RodrigoQ99/PCIe-Switch-4xNVMe/esquematico/BOM_PCIe_Switch_4xNVMe.csv

Item | Cantidad | Valor | Parte | Footprint | Referencias
1 | 6 | HI1812V101R-10 | BEAD | L1812 | BD1 BD3 BD4 BD6 BD7 BD8
2 | 11 | 22uF25V | C_MLCC | C1206 | C1 C2 C8 C10 C12 C13 C16 C28 C31 C36 C41
3 | 2 | 100uF/16V | CAP_0 | 7_3X4_3X2_8 | C3 C29
4 | 28 | 0.1uF | C_MLCC | C0402 | C4 C5 C9 C11 C14 C15 C17 C30 C32 C37 C39 C40 C42 C43 C44 C53 C54 C102 C103 C104 C107 C108 C110 C111 C114 C115 C116 C117
5 | 6 | 47uF6.3V | C_MLCC | C0805 | C6 C33 C144 C145 C150 C155
6 | 2 | 330uF/6.3V | CAP_0 | 7_3X4_3X2_8 | C7 C34
7 | 2 | X_SS | C_MLCC | C0402 | C18 C35
8 | 3 | 47uF25V | C_MLCC | C1206 | C19 C20 C21
9 | 5 | 100uF6.3V | C_MLCC | C1206 | C22 C23 C24 C25 C26
10 | 1 | 470uF/6.3V | CAP_0 | 7_3X4_3X2_8 | C27
11 | 7 | 10uF10V | C_MLCC | C0603 | C38 C45 C52 C100 C109 C113 C118
12 | 8 | 0.22uF | C_MLCC_0 | C0402 | C46 C47 C48 C49 C50 C51 C55 C56
13 | 14 | 10uF/6.3V | C_MLCC_0 | C0402 | C99 C101 C106 C119 C123 C127 C131 C135 C140 C146 C151 C156 C160 C164
14 | 1 | 0.1uF | C_MLCC_0 | C0402 | C112
15 | 11 | 4.7uF/6.3V | C_MLCC_0 | C0402 | C120 C124 C128 C132 C136 C141 C147 C152 C157 C161 C165
16 | 20 | 0.1uF | C_MLCC | C0402 | C121 C122 C125 C126 C129 C130 C133 C134 C137 C142 C143 C148 C149 C153 C154 C158 C159 C162 C166 C167
17 | 2 | X_100uF6.3V | C_MLCC | C1206 | C138 C139
18 | 1 | 47uF6.3V | C_MLCC | C0805 | C163
19 | 2 | 0.1uF | C_MLCC | C0402 | C244 C245
20 | 8 | 220nF | CAP NP | c0402 | C741 C742 C751 C752 C761 C762 C771 C772
21 | 8 | 22uF | CAP NP | c0805 | C743 C744 C753 C754 C763 C764 C773 C774
22 | 8 | 0.1uF | CAP NP | c0402 | C745 C746 C755 C756 C765 C766 C775 C776
23 | 5 | Red | LED_0 | LED-0805 | DS1 DS2 DS3 DS4 DS5
24 | 4 | M.2_M-KEY_2280 | HEADER 38x2 | M2_MKEY_2280 | J44 J45 J46 J47
25 | 1 | X_PCIex4 | PCIex4 | PCI_EXPRESS_X4 | P2
26 | 1 | PWRCONN6P | PWR_ATX12V_3 | 455580003 | PWR1
27 | 2 | 2N7002A | NMOS_SGD_0 | SOT23SGD_T | Q1 Q2
28 | 14 | 0R | R_2P | R0402 | R1 R3 R6 R10 R20 R22 R48 R139 R153 R154 R155 R156 RB2 RB4
29 | 5 | X_0R | R_2P | R0402 | R2 R7 R8 R21 R135
30 | 2 | 2.45K 1% | R_2P | R0402 | R4 R23
31 | 2 | 1M 1% | R_2P | R0402 | R5 R24
32 | 1 | X_66k | R_2P | R0402 | R9
33 | 1 | 1K | R_2P | R0402 | R11
34 | 15 | 330R | R_2P | R0402 | R12 R13 R17 R19 R72 R79 RD1 RD2 RD5 RD14 RD15 RD17 RD18 RD19 RD85
35 | 1 | 326R1% | R_2P | R0402 | R14
36 | 20 | 5.1K | R_2P | R0402 | R16 R18 R51 R52 R54 R55 R143 R144 R148 R152 RP7 RP8 RP9 RP10 RP11 RP12 RP75 RP76 RP176 RP177
37 | 1 | 3.9K1% | R_2P | R0402 | R25
38 | 2 | 20K1% | R_2P | R0402 | R26 R28
39 | 1 | 25K1% | R_2P | R0402 | R27
40 | 2 | X_0R | R_2 | R0402 | R29 R30
41 | 1 | X_330R | R_2P | R0402 | R59
42 | 1 | 200K | R_2P | R0402 | R74
43 | 10 | 0R | R | R0402 | R88 R89 R90 R91 R92 R93 R157 R158 R159 R160
44 | 1 | 200R1% | R_4 | R0402 | R102
45 | 6 | X_330R | R | R0402 | RD7 RD8 RD9 RD10 RD11 RD12
46 | 3 | 330R | R | R0402 | RD13 RD81 RD82
47 | 2 | X_1.82K | R_2P | R0402 | RP21 RP23
48 | 2 | 1.16K | R_2P | R0402 | RP24 RP25
49 | 2 | 5.1K | R | R0402 | RP87 RP200
50 | 14 | X_TESTPOINT | TP_0 | TESTPIN25 | TP1 TP2 TP3 TP4 TP5 TP6 TP7 TP8 TP9 TP10 TP11 TP12 TP13 TP14
51 | 2 | LMZ31704/07/10 | LMZ31704/70/10 | B3QFN-42 | U1 U3
52 | 1 | LMZ31530/20 | LM31530/20 | QFN72-16R15X15R15-_8 | U2
53 | 2 | AP7361C-FGE-7 | AP7361C_0 | DFN8-0303-_65 | U4 U5
54 | 1 | PI7C9X3G808GP | PI7C9X3G808GP_17 | HFCBGA_196_15X15 | U6
55 | 1 | PI4ULS5V108LEX | PI4ULS5V108LEX | tssop20-6_5-_65 | U10
56 | 1 | 74HC08S14-13 | 74HC08_6 | SO14-6-1_27 | U23
57 | 1 | PT7M7811STBE | TCM811_1 | SOT143 | U27
