RodrigoQ99/PCIe-Switch-4xNVMe/(list of files, cad)

Other CAD files:
layout/footprints/455580003.psm
layout/footprints/7_3x4_3x2_8.psm
layout/footprints/b3qfn-42.psm
layout/footprints/c0402.psm
layout/footprints/c0402_bga.psm
layout/footprints/c0603.psm
layout/footprints/c0805.psm
layout/footprints/c1206.psm
layout/footprints/dfn8-0303-_65.psm
layout/footprints/hfcbga_196_15x15.psm
layout/footprints/l1812.psm
layout/footprints/led-0805.psm
layout/footprints/m2_mkey_2280.psm
layout/footprints/pci_express_x4.psm
layout/footprints/qfn72-16r15x15r15-_8.psm
layout/footprints/r0402.psm
layout/footprints/so14-6-1_27.psm
layout/footprints/sot23sgd_t.psm
layout/footprints/testpin25.psm
layout/footprints/tssop20-6_5-_65.psm
