RodrigoQ99/PCIe-Switch-4xNVMe/esquematico/PCIe_Switch_4xNVMe_esquematico.pdf

5

4

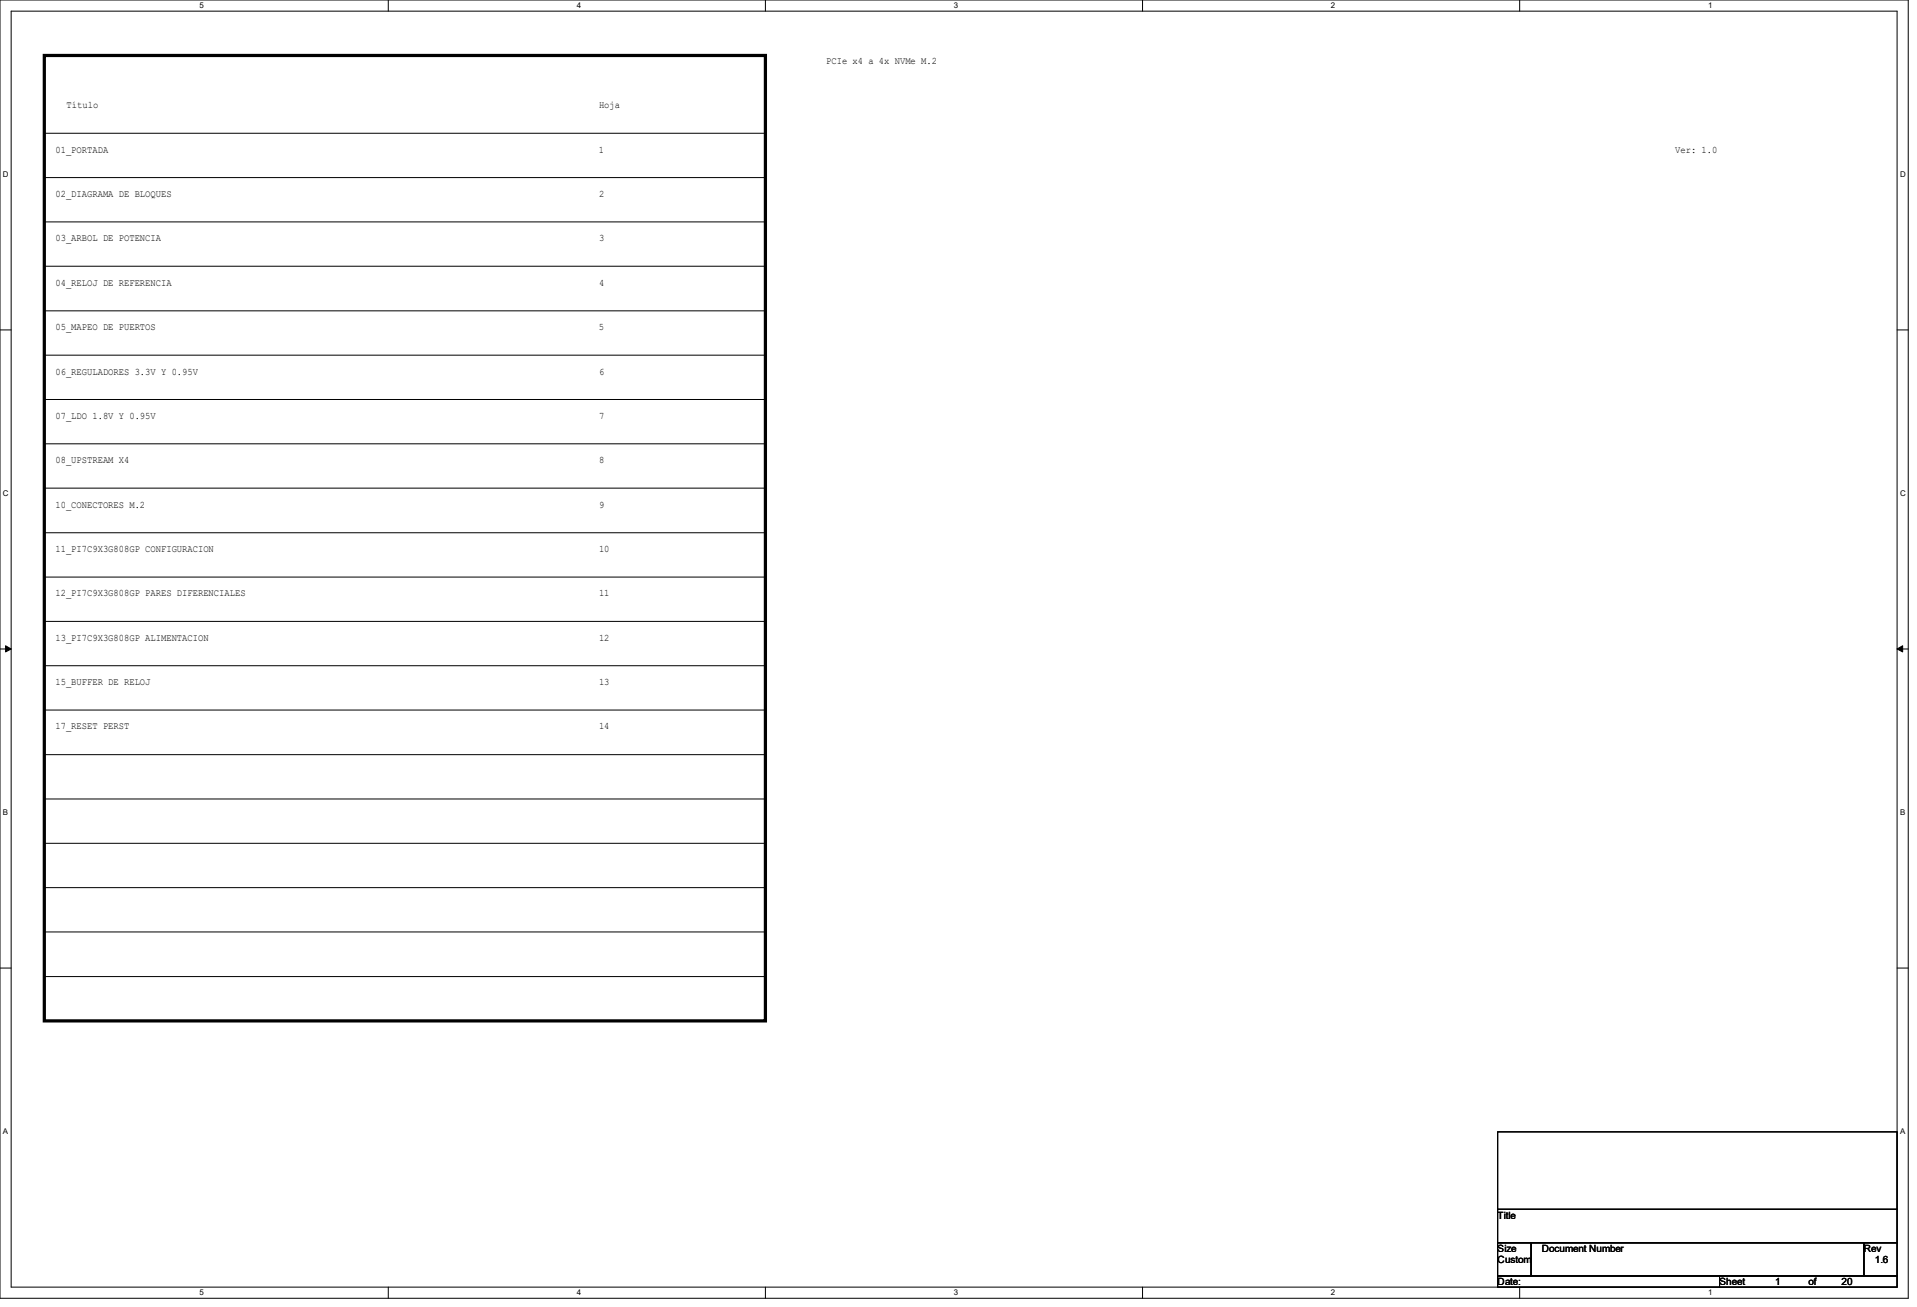
[picture p6: page 1]
01_PORTADA; Título; Hoja; 10_CONECTORES M.2; 03_ARBOL DE POTENCIA; 05_MAPEO DE PUERTOS; PCIe x4 a 4x NVMe M.2; 12_PI7C9X3G808GP PARES DIFERENCIALES; 15_BUFFER DE RELOJ; 11_PI7C9X3G808GP CONFIGURACION; Ver: 1.0; 08_UPSTREAM X4; 13_PI7C9X3G808GP ALIMENTACION; 04_RELOJ DE REFERENCIA; 02_DIAGRAMA DE BLOQUES; 17_RESET PERST; 06_REGULADORES 3.3V Y 0.95V; 07_LDO 1.8V Y 0.95V; Title Size; Document Number; Rev Date:; Sheet; of Custom; 20 Title Size

## DIAGRAMA DE BLOQUES - PCIe Gen3 x4 a 4 SSD NVMe M.2

## P2 - Gold fingers x4

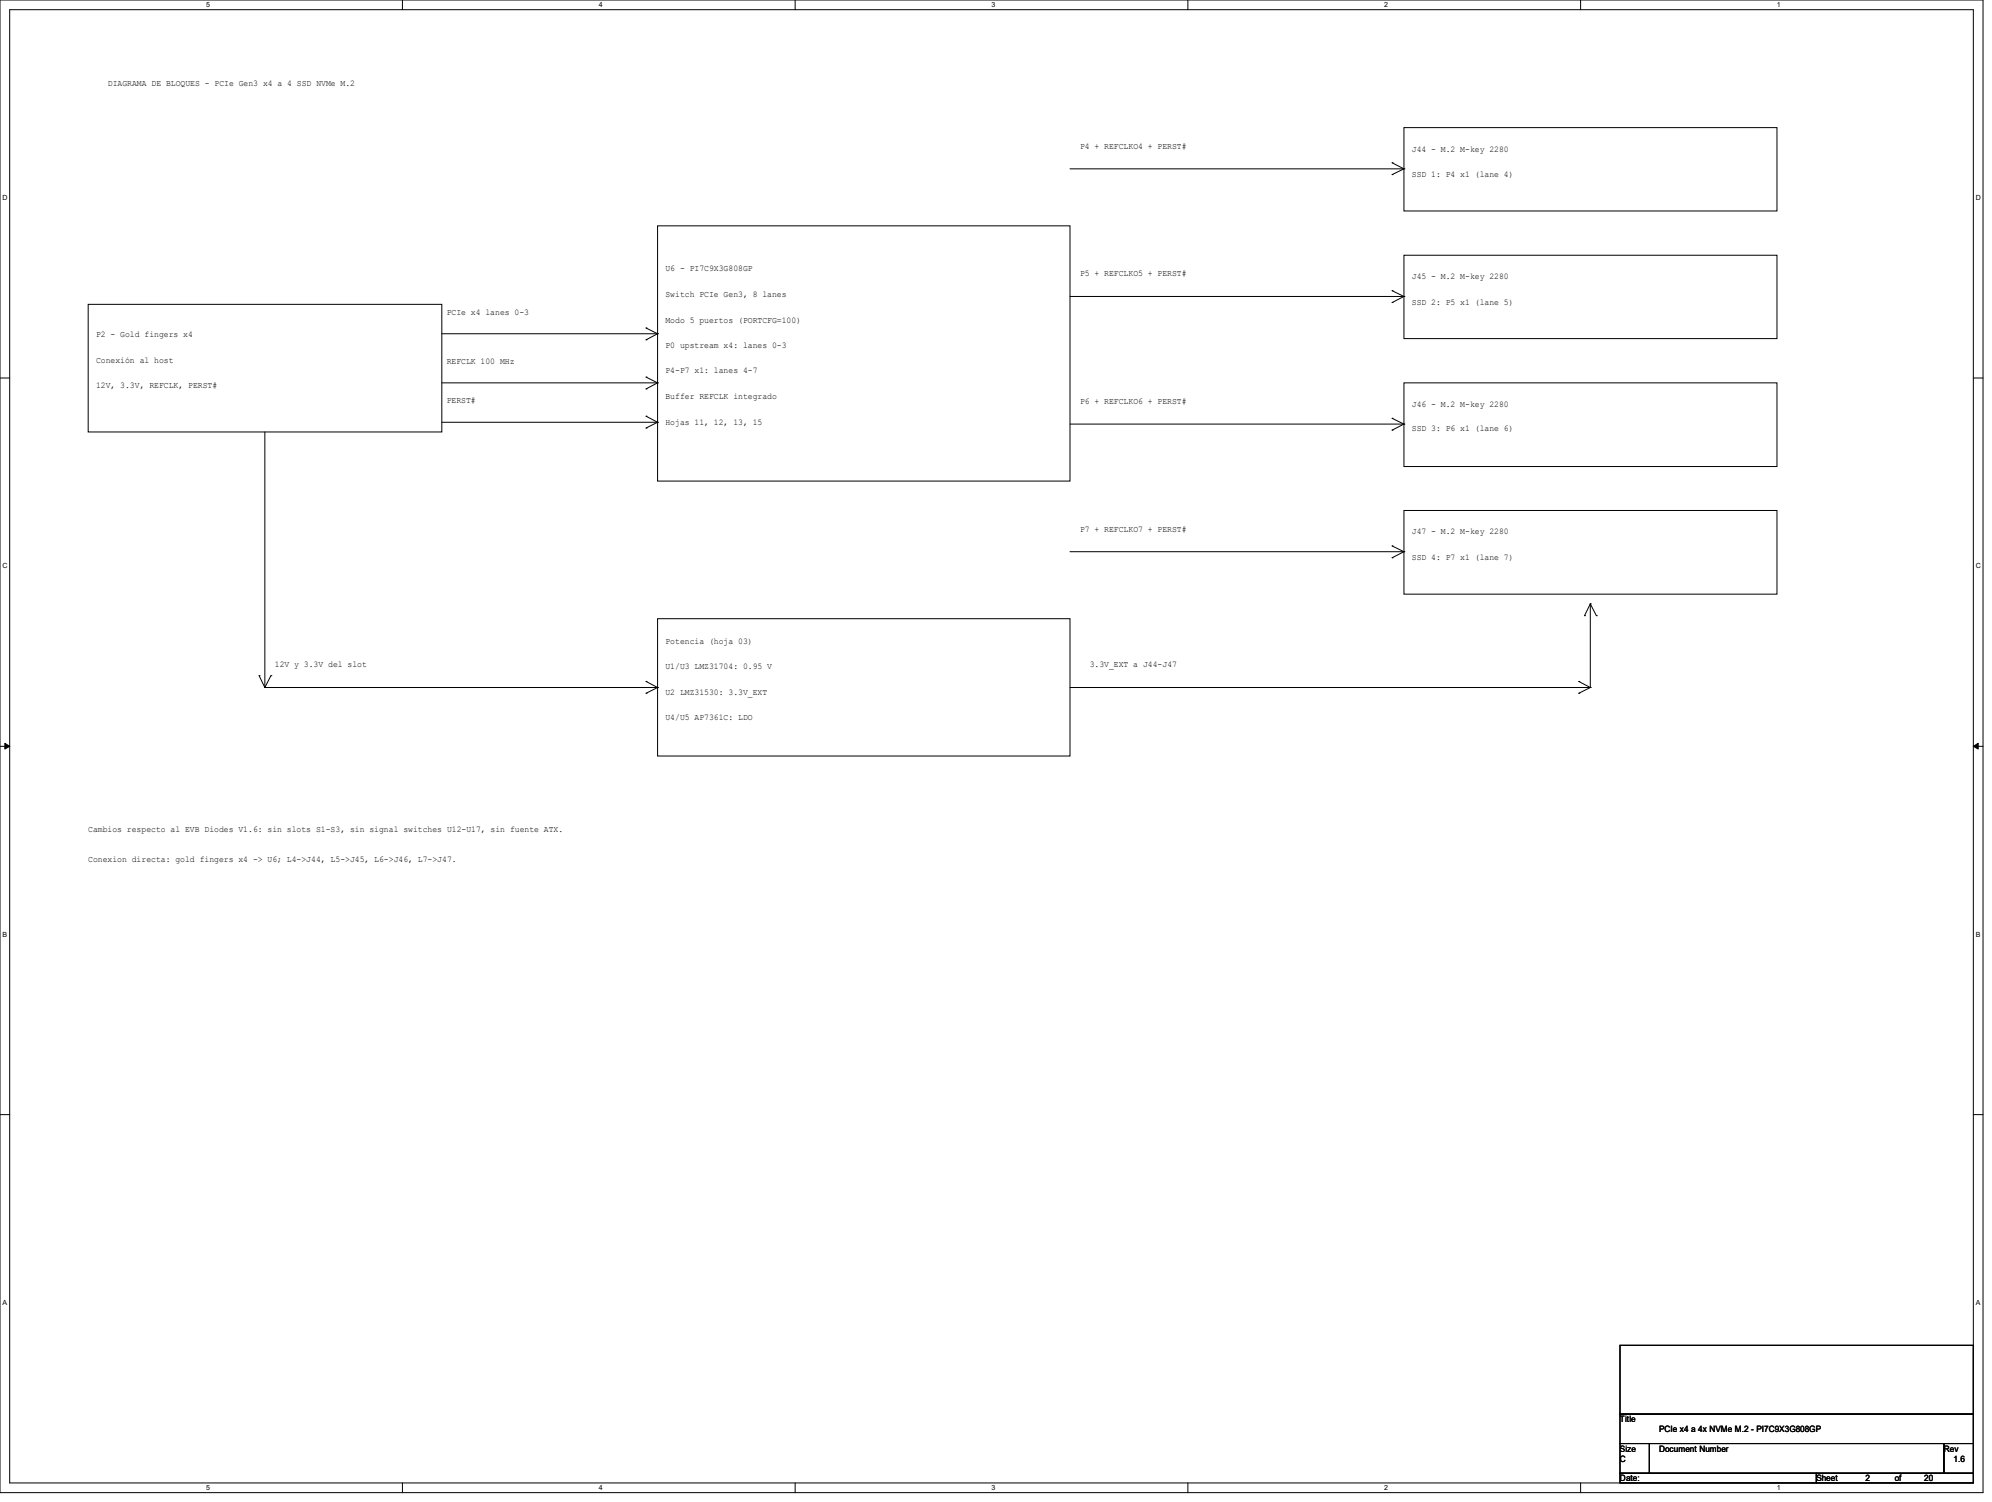
[picture p7: page 2]

Cambios respecto al EVB Diodes V1.6: sin slots S1-S3, sin signal switches U12-U17, sin fuente ATX.

Conexion directa: gold fingers x4 -> U6; L4->J44, L5->J45, L6->J46, L7->J47.

D D

# ÁRBOL DE POTENCIA

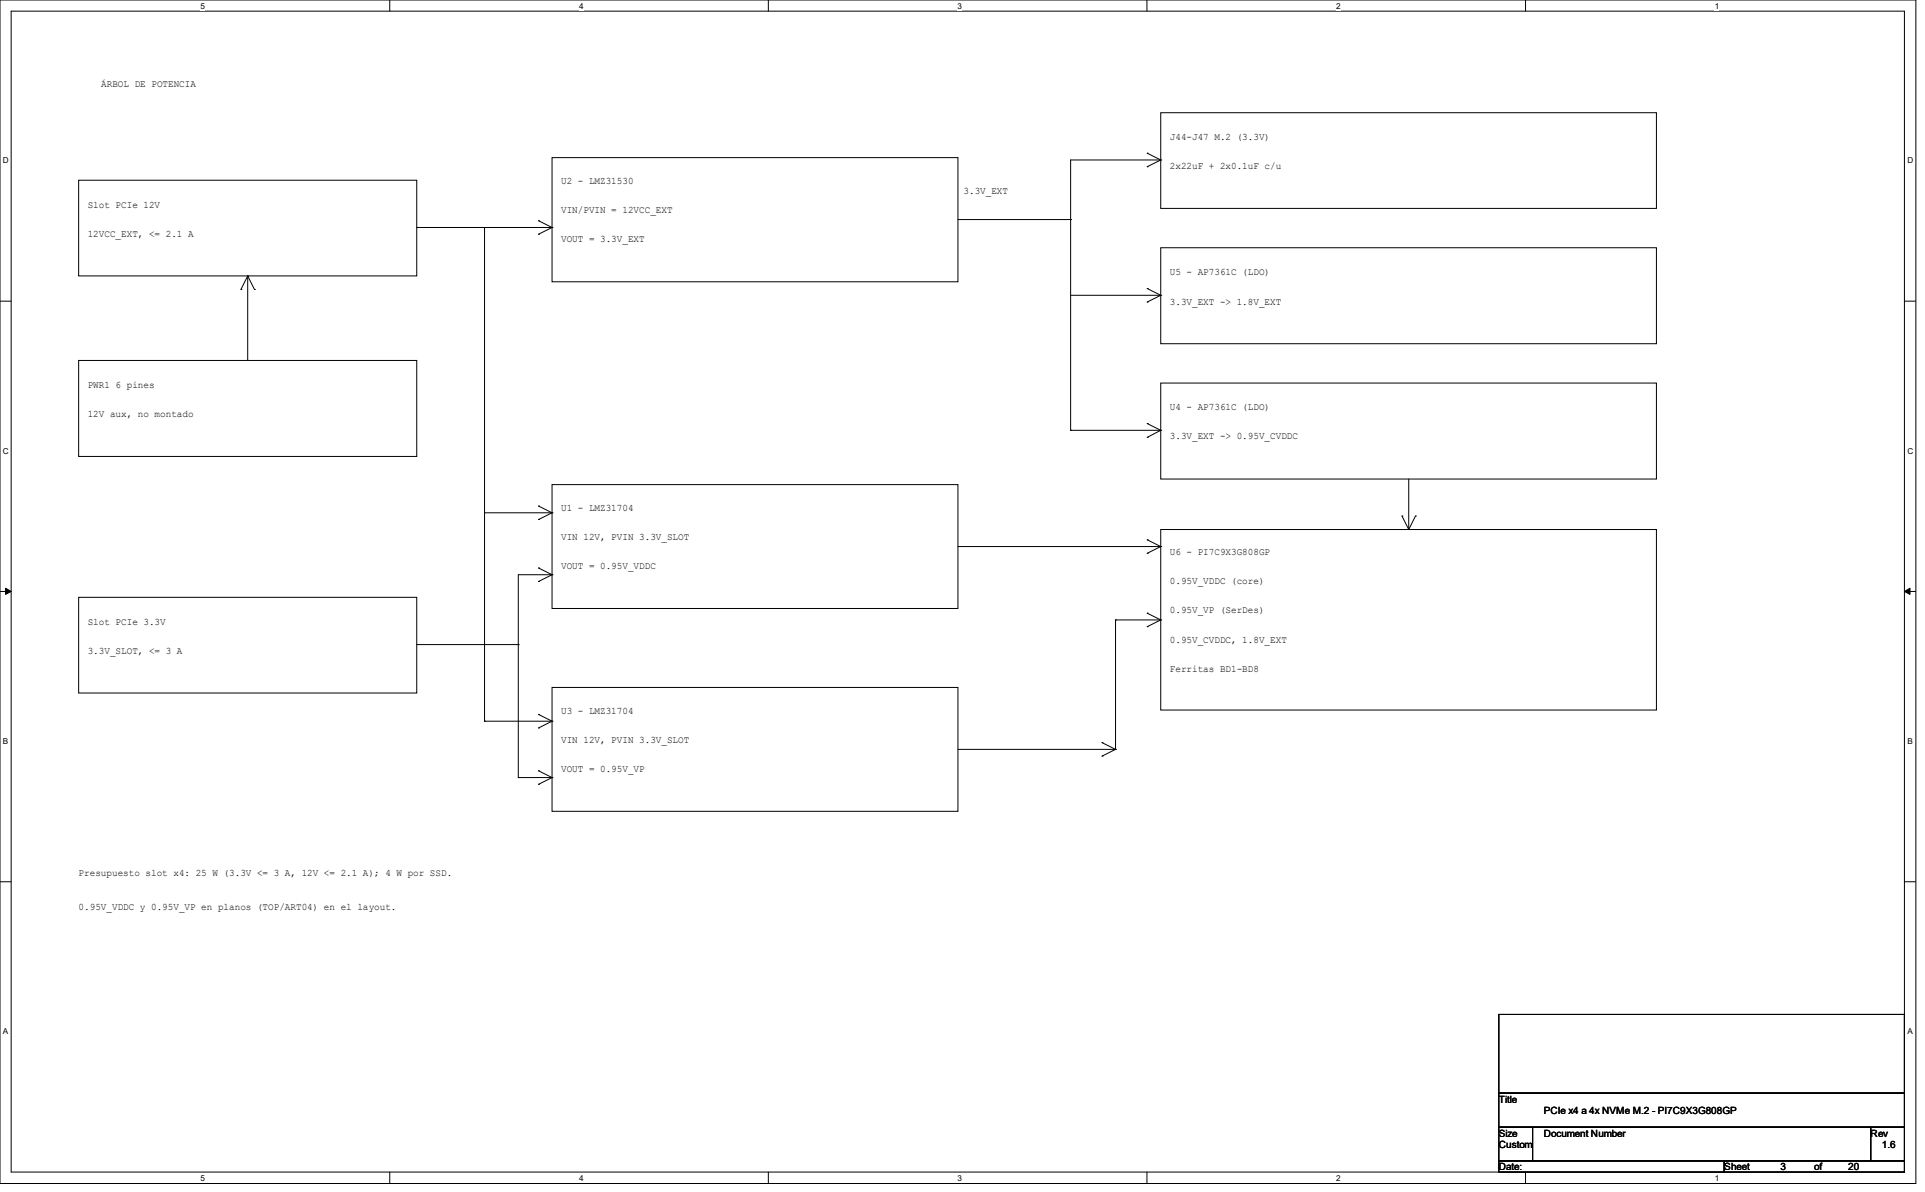
[picture p8: page 3]
Slot PCIe 12V; 12VCC_EXT, <= 2.1 A; PWR1 6 pines; Slot PCIe 3.3V; 3.3V_SLOT, <= 3 A; U2 - LMZ31530; VIN/PVIN = 12VCC_EXT; VOUT = 3.3V_EXT; U1 - LMZ31704; VIN 12V, PVIN 3.3V_SLOT; VOUT = 0.95V_VDDC; U3 - LMZ31704; VOUT = 0.95V_VP; U5 - AP7361C (LDO); 3.3V_EXT -> 1.8V_EXT; U4 - AP7361C (LDO); 3.3V_EXT -> 0.95V_CVDDC; 3.3V_EXT; 0.95V_VDDC (core); 0.95V_VP (SerDes); 0.95V_CVDDC, 1.8V_EXT; Ferritas BD1-BD8; 0.95V_VDDC y 0.95V_VP en planos (TOP/ART04) en el layout.; Title Size; Document Number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

12V aux, no montado

Presupuesto slot x4: 25 W (3.3V <= 3 A, 12V <= 2.1 A); 4 W por SSD.

## RELOJ DE REFERENCIA (REFCLK) 100 MHz

## P2 - Gold fingers

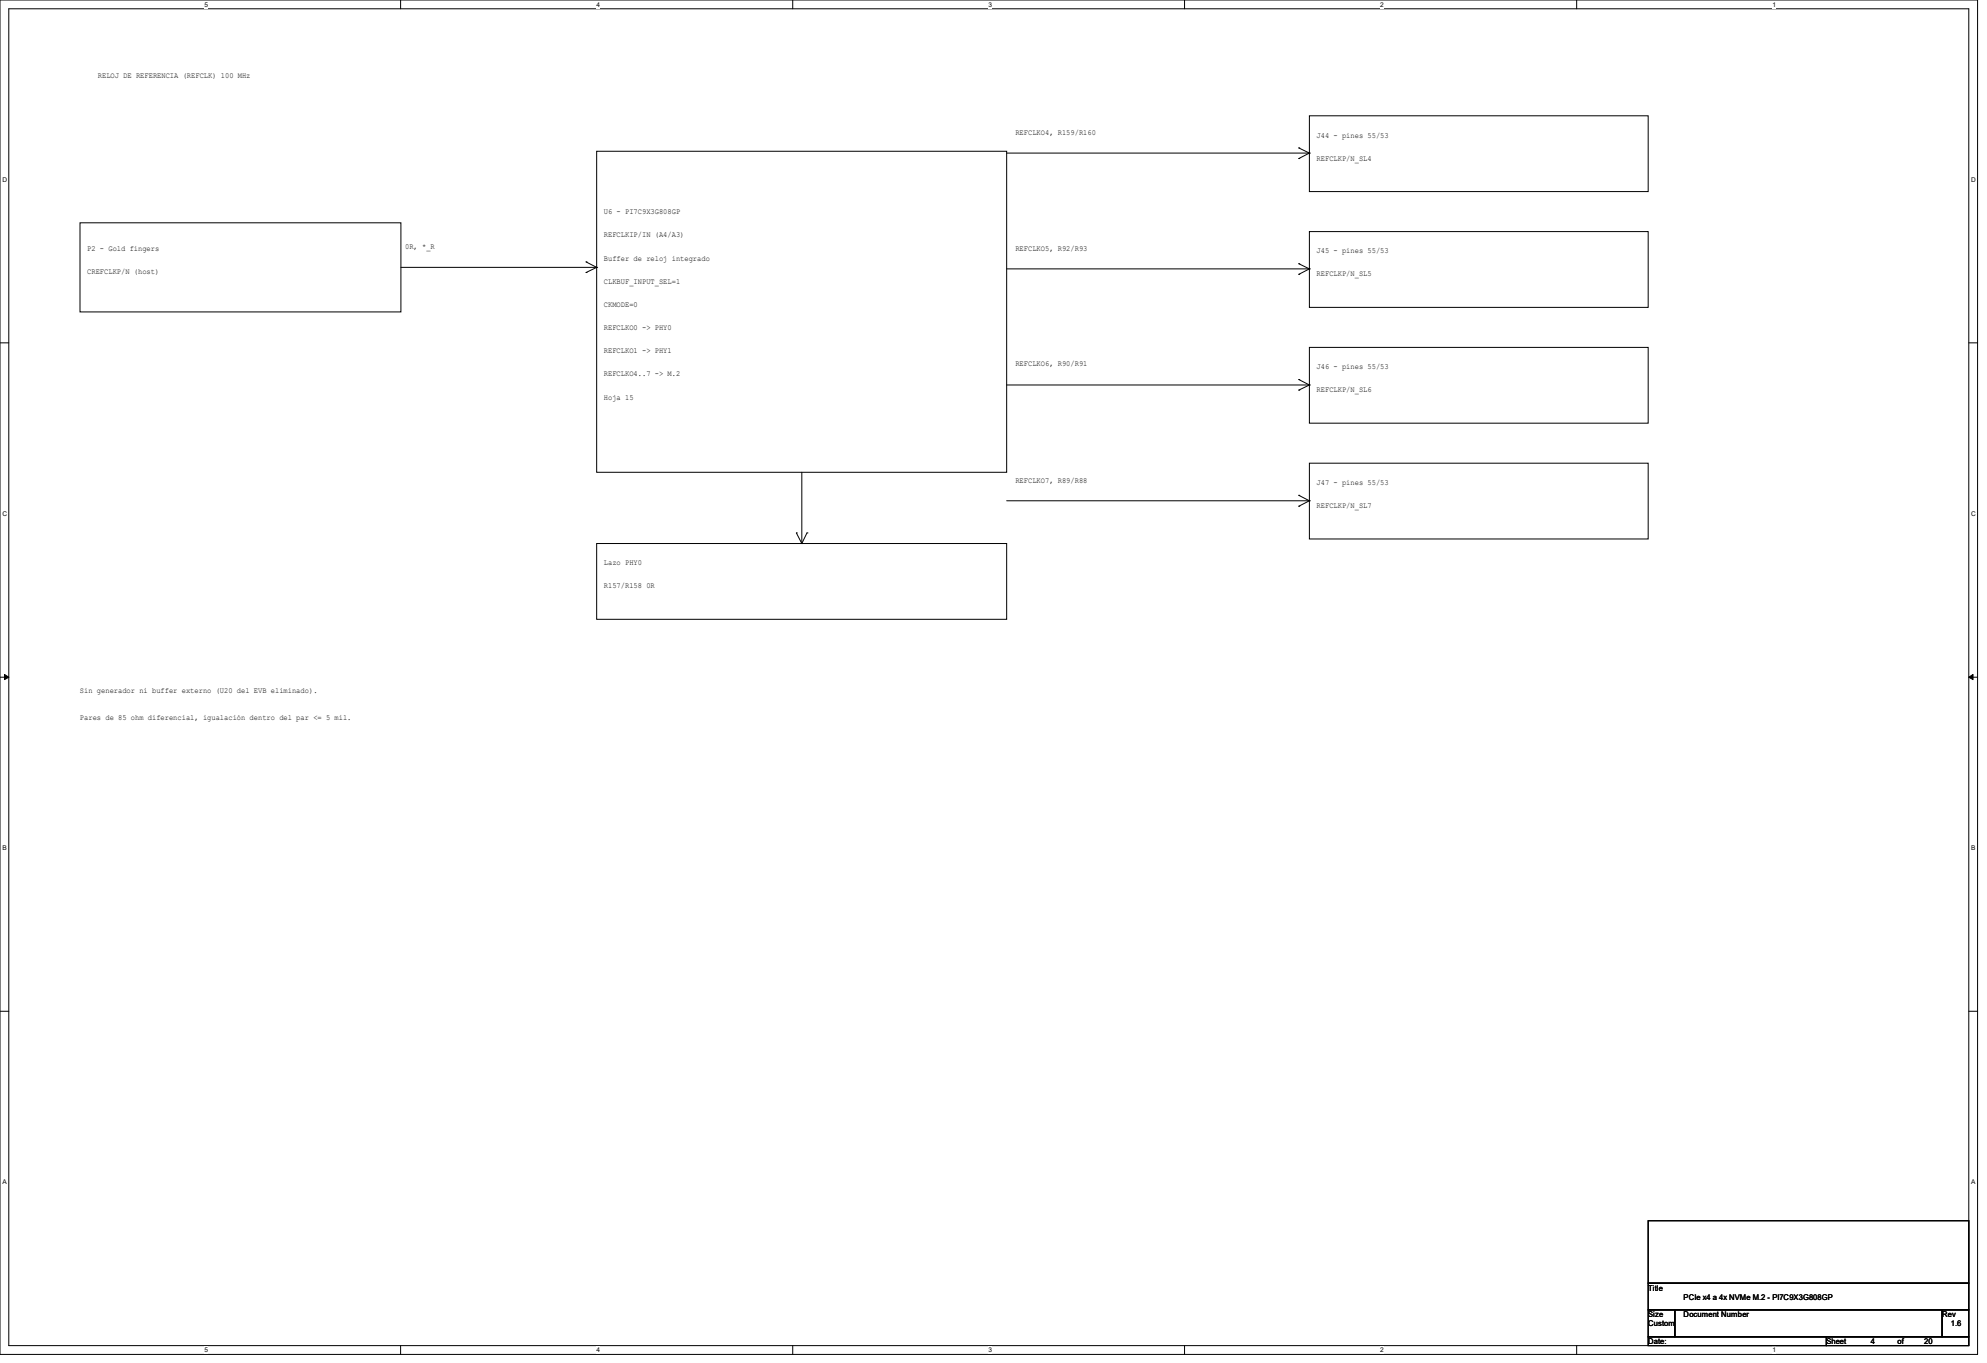
[picture p9: page 4]
CREFCLKP/N (host); REFCLKIP/IN (A4/A3); CLKBUF_INPUT_SEL=1; CKMODE=0; REFCLKO0 -> PHY0; REFCLKO1 -> PHY1; REFCLKO4..7 -> M.2; Hoja 15; Lazo PHY0; J44 - pines 55/53; REFCLKP/N_SL4; REFCLKO4, R159/R160; J45 - pines 55/53; REFCLKP/N_SL5; REFCLKO5, R92/R93; J46 - pines 55/53; REFCLKP/N_SL6; REFCLKO6, R90/R91; J47 - pines 55/53; REFCLKP/N_SL7; REFCLKO7, R89/R88; Title Size; Document Number; Rev Date:; Sheet; 1.6 PCIe x4 a 4x NVMe M.2 - PI7C9X3G808GP Custom; 20 Title Size

Buffer de reloj integrado

Sin generador ni buffer externo (U20 del EVB eliminado).

Pares de 85 ohm diferencial, igualación dentro del par <= 5 mil.

D D

# Mapeo de puertos y lanes

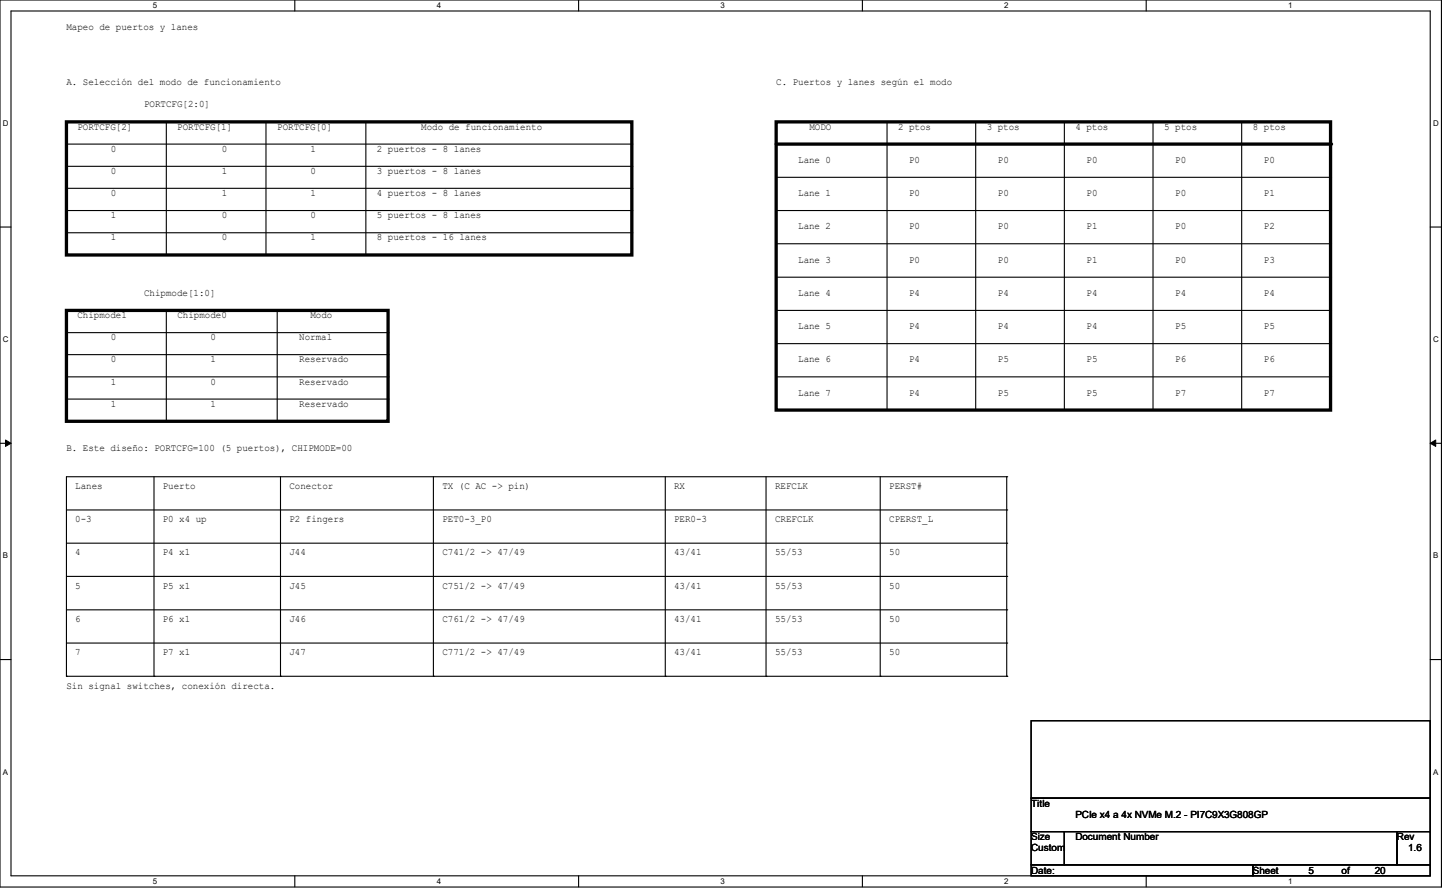
[picture p10: page 5]

B. Este diseño: PORTCFG=100 (5 puertos), CHIPMODE=00

Lanes | Puerto | Conector | TX (C AC -> pin) | RX | REFCLK | PERST#

0-3 | P0 x4 up | P2 fingers | PET0-3_P0 | PER0-3 | CREFCLK | CPERST_L

## LMZ31704/07/10 PGND 20 VIN

# 42 AGND 23 TP13

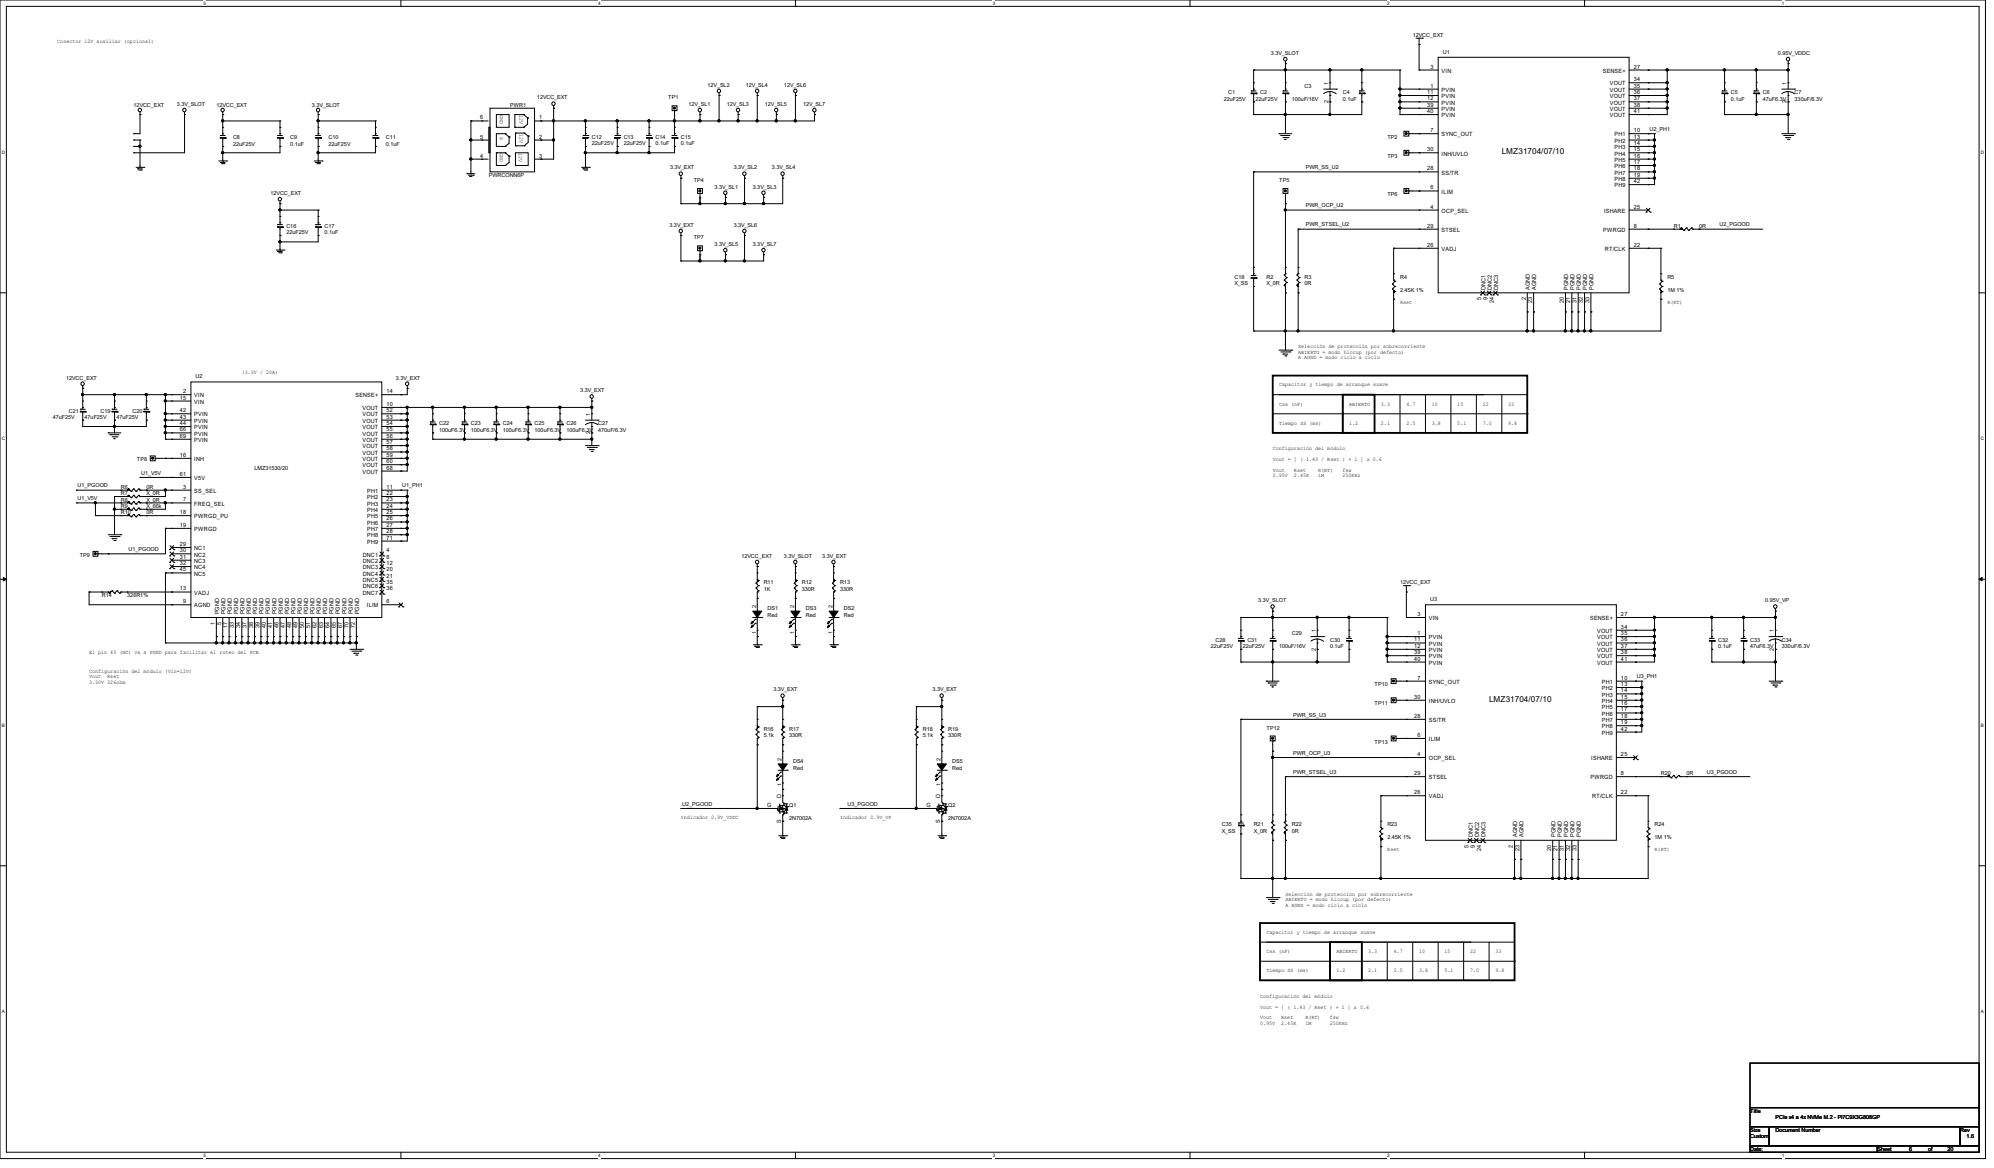
[picture p11: page 6]

Selección de protección por sobrecorriente
ABIERTO = modo hiccup (por defecto)
A AGND = modo ciclo a ciclo

Capacitor y tiempo de arranque suave

El pin 45 (NC) va a PGND para facilitar el ruteo del PCB

Configuración del módulo (Vin=12V)
Vout Rset
3.30V 326ohm

D D

(0.95V / 1A)

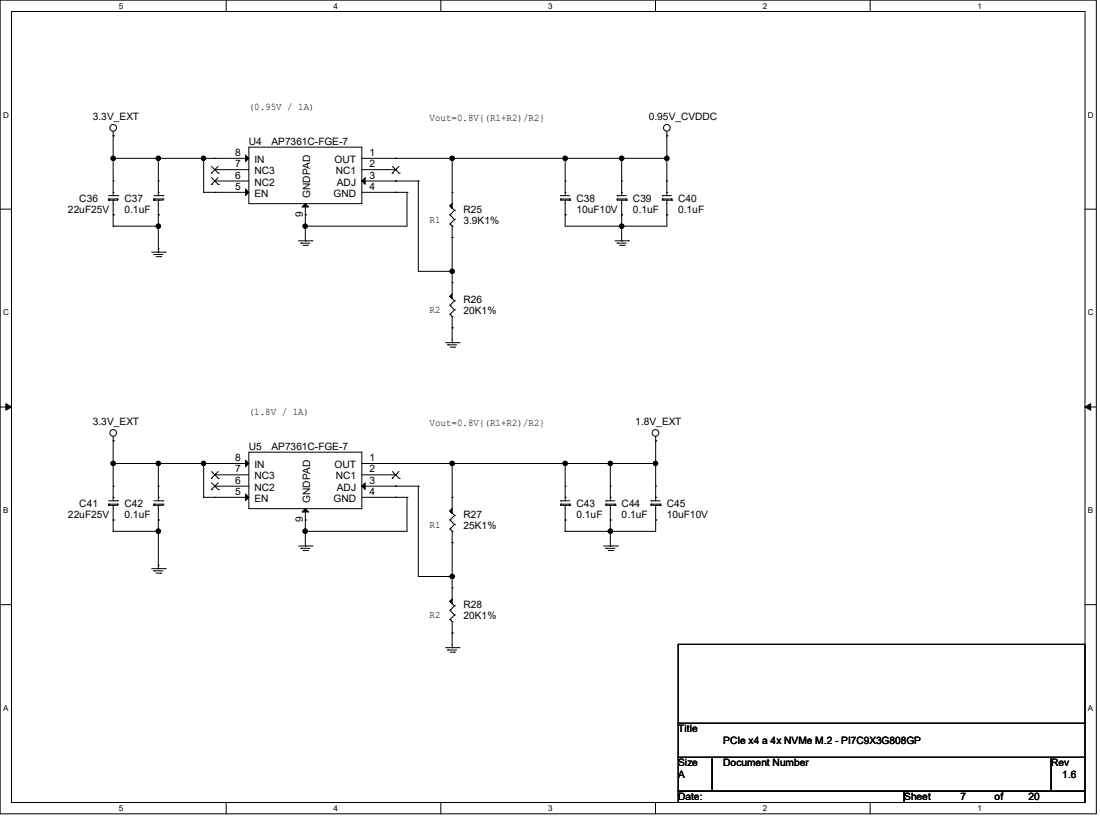
[picture p12: page 7]

D D

# Lanes 0~3

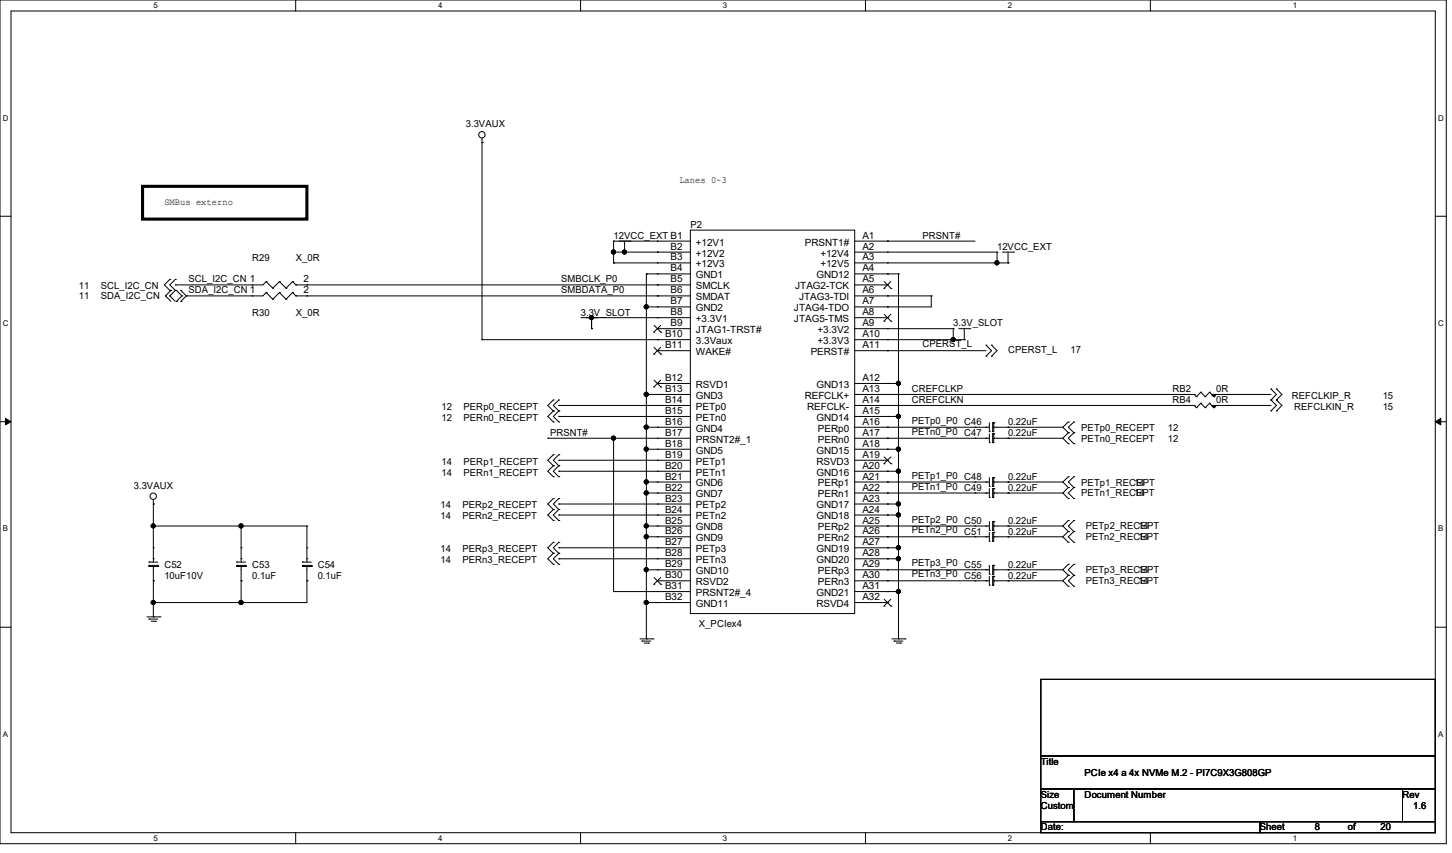
[picture p13: page 8]

# J45 M.2_M-KEY_2280

# J44 M.2_M-KEY_2280

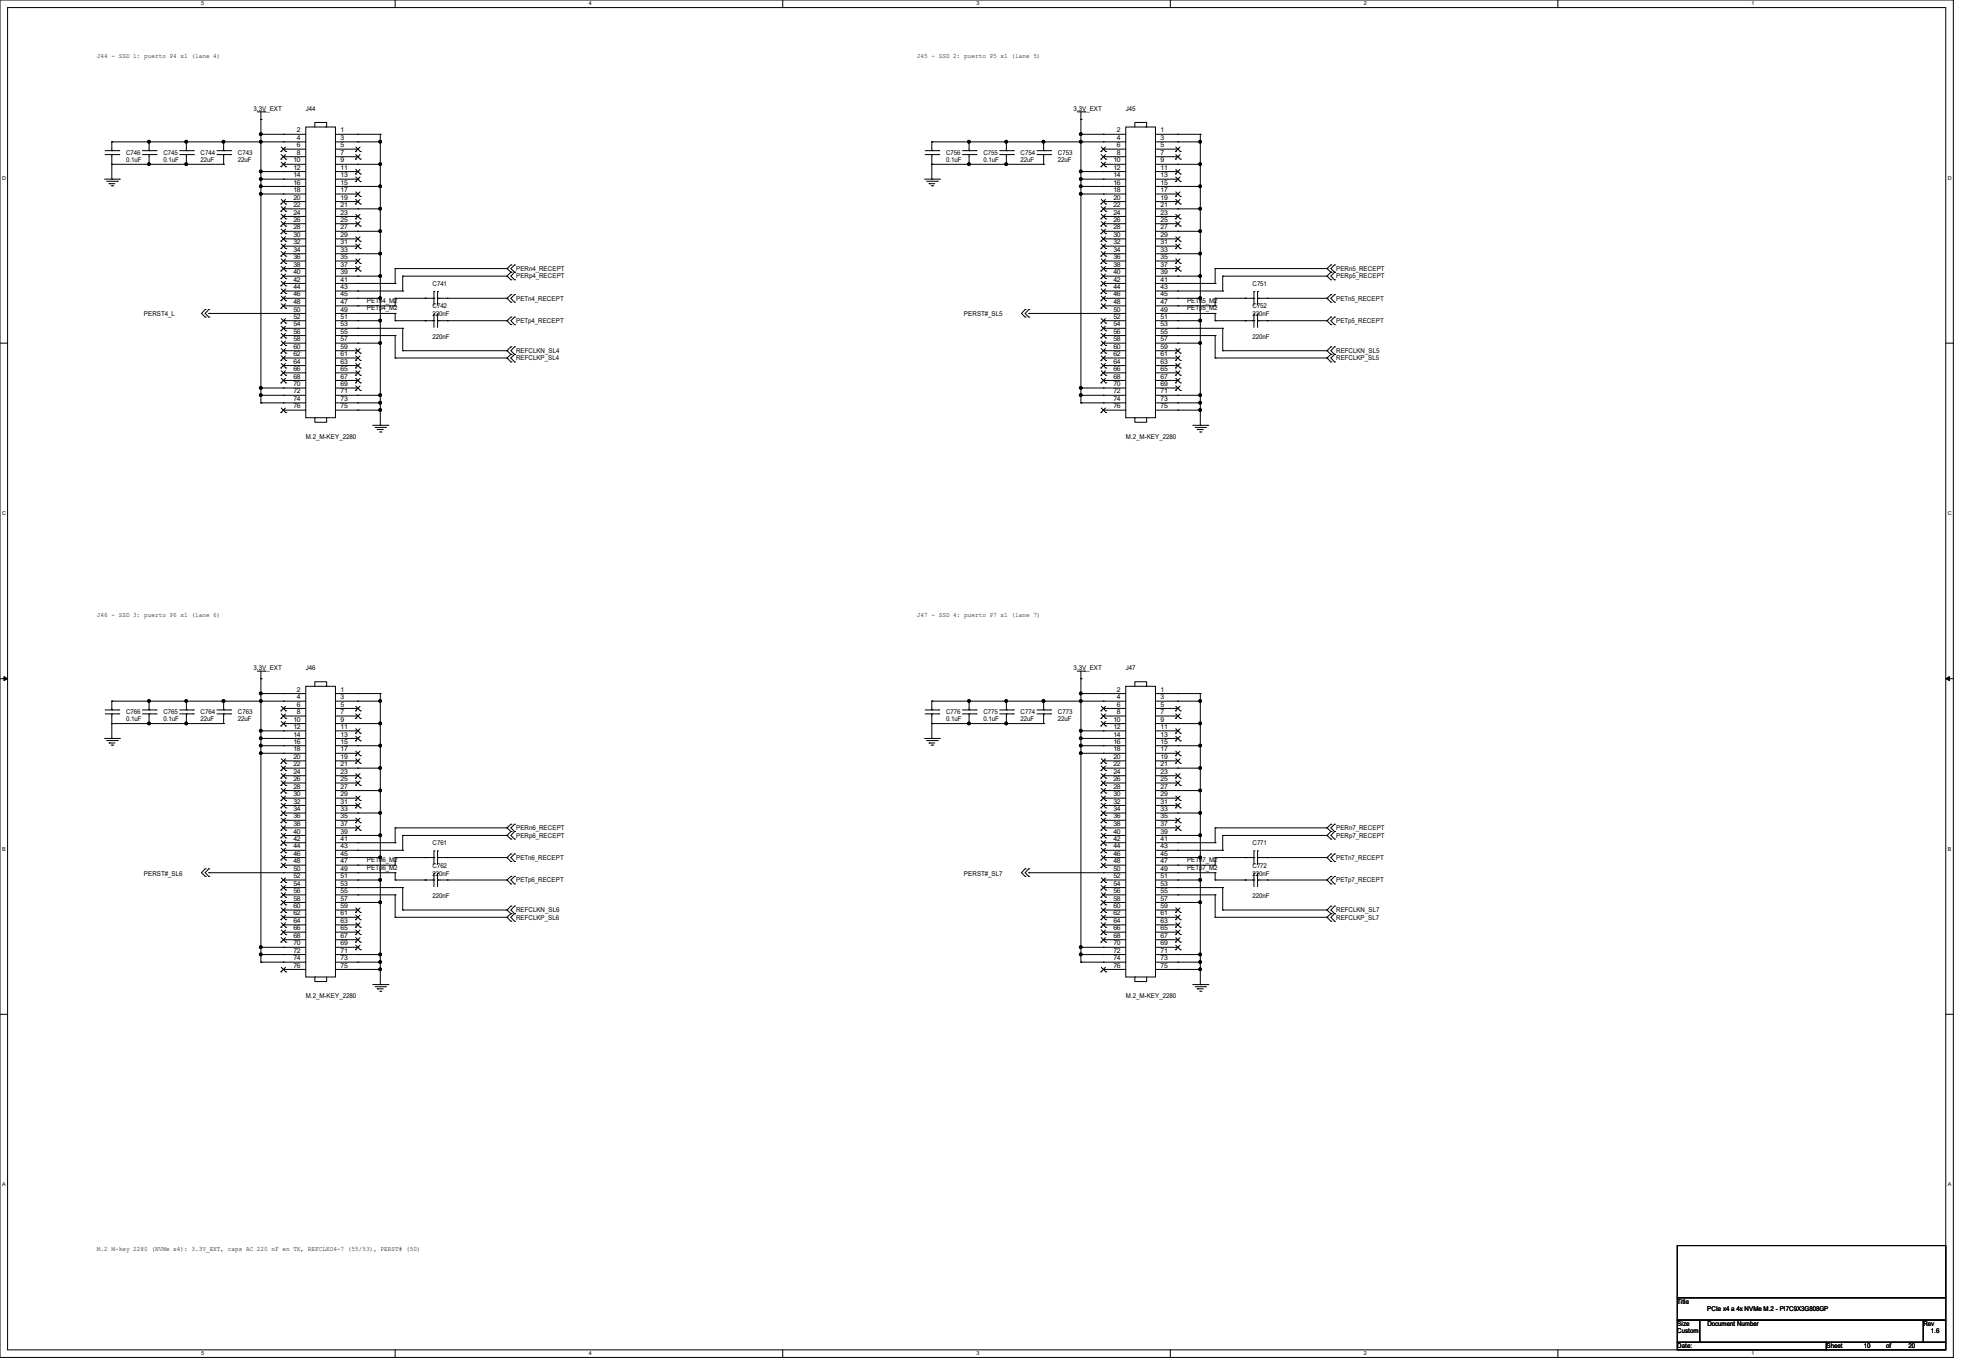
[picture p14: page 9]

M.2 M-key 2280 (NVMe x4): 3.3V_EXT, caps AC 220 nF en TX, REFCLKO4-7 (55/53), PERST# (50)

RD85 | 330R | RD⁹ X_330R

# I2C_ADDR2 M12 EEDI K12 EECS_L K14 EECK

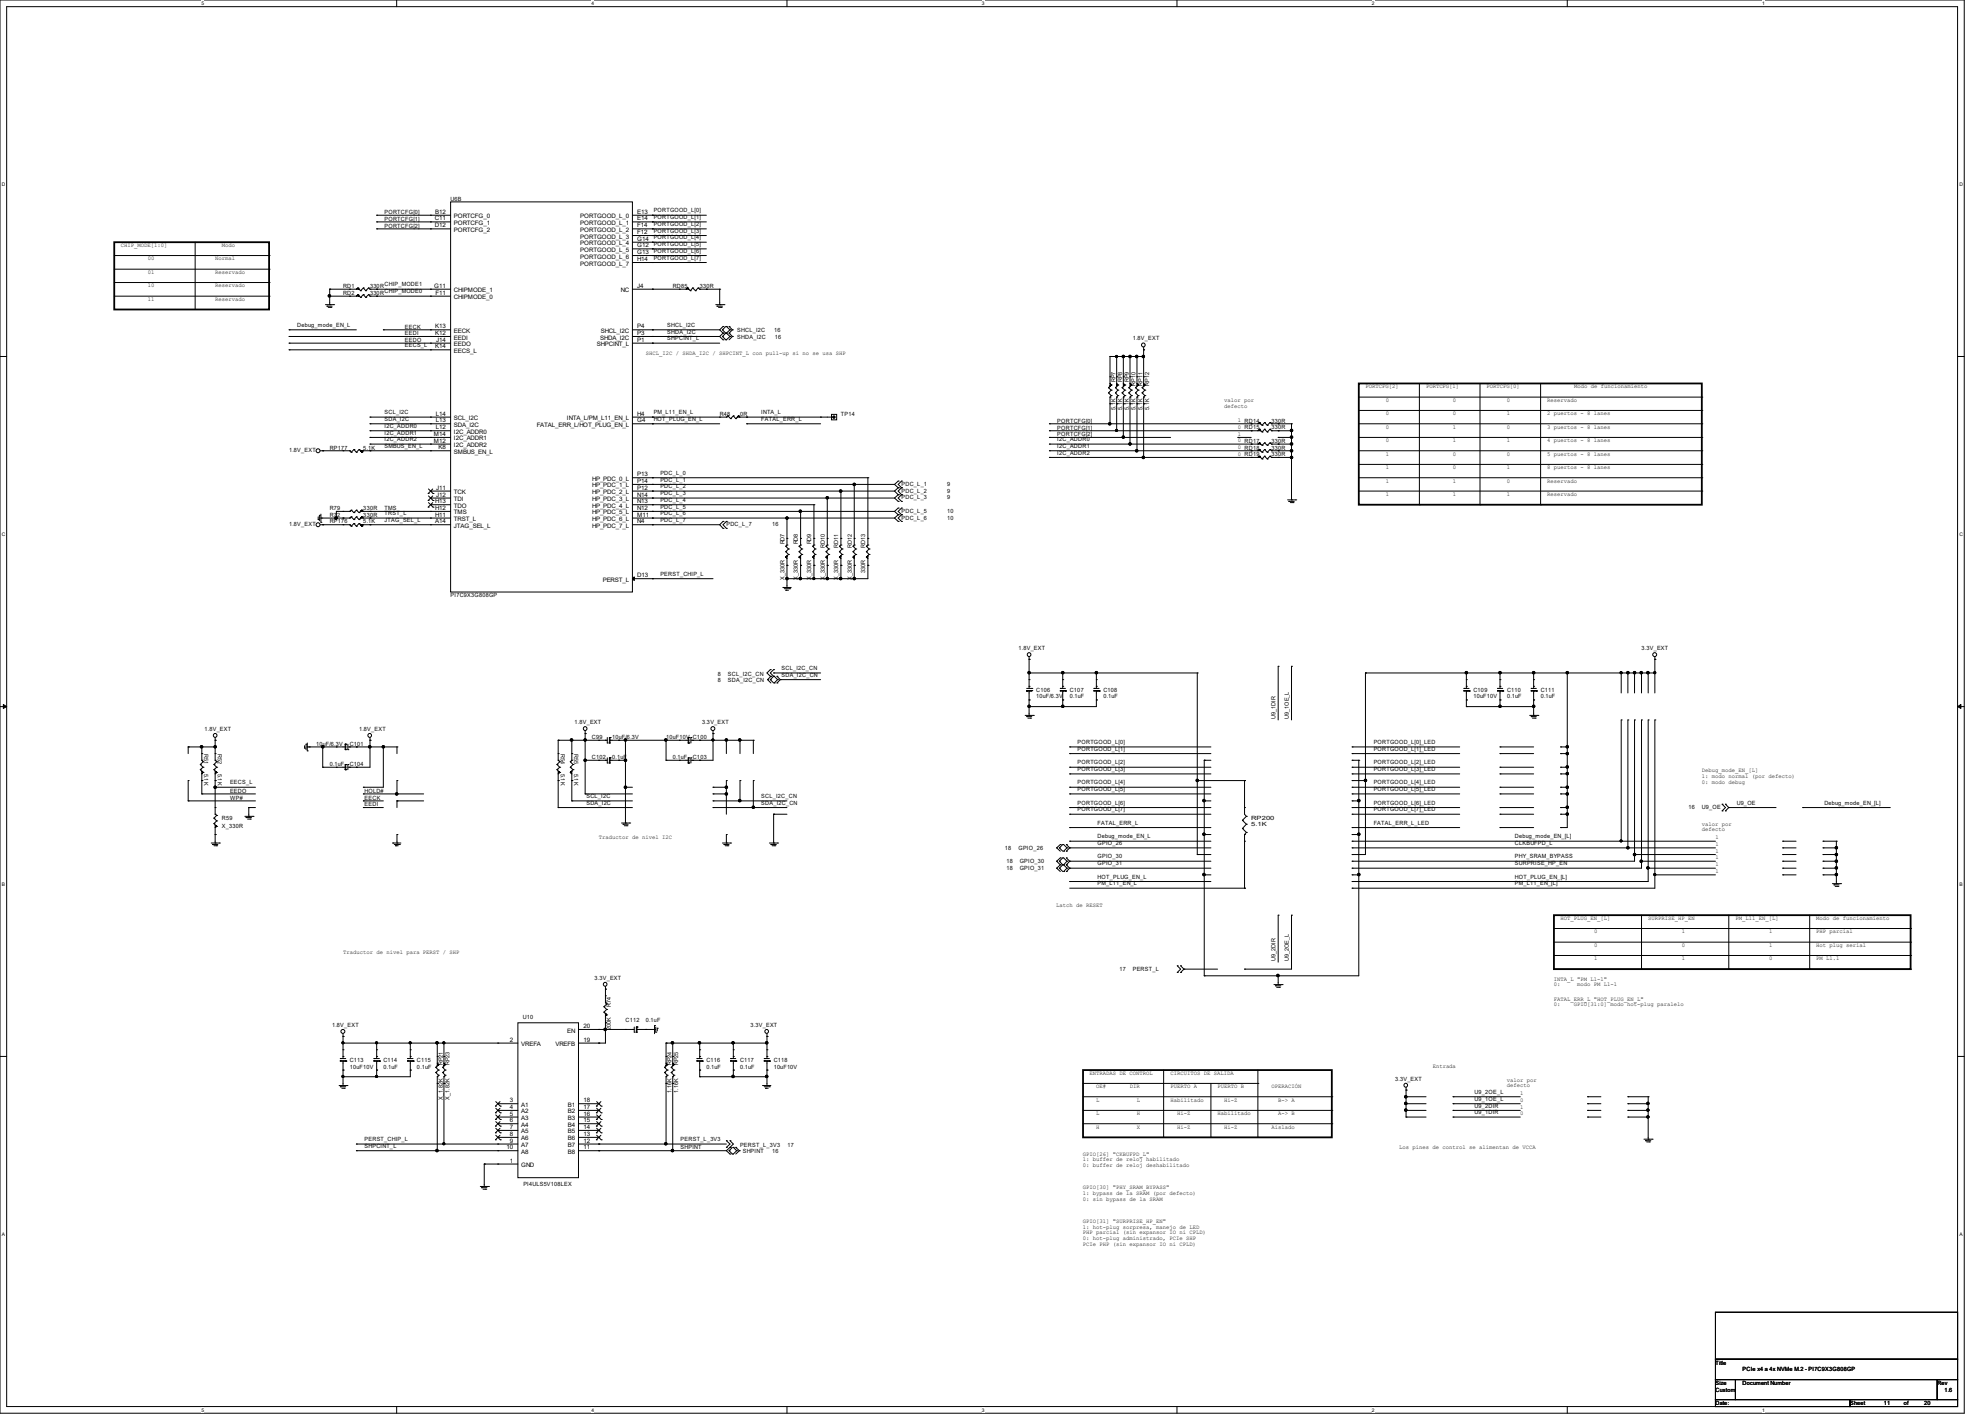
[picture p15: page 10]

PORTGOOD_L[0] PORTGOOD_L[1] PORTGOOD_L[2] PORTGOOD_L[3] PORTGOOD_L[4] PORTGOOD_L[5] PORTGOOD_L[6] PORTGOOD_L[7] CHIP_MODE0 CHIP_MODE1 EECK
PM_L11_EN_L PORTCFG[0] PORTCFG[1] PORTCFG[2] TMS

SHCL_I2C / SHDA_I2C / SHPCINT_L con pull-up si no se usa SHP

Debug_mode_EN_[L]
1: modo normal (por defecto)
0: modo debug

Traductor de nivel para PERST / SHP

GPIO[26] "CKBUFPD_L"
1: buffer de reloj habilitado
0: buffer de reloj deshabilitado

Los pines de control se alimentan de VCCA

GPIO[30] "PHY_SRAM_BYPASS"
1: bypass de la SRAM (por defecto)
0: sin bypass de la SRAM

1: hot-plug sorpresa, manejo de LED
PHP parcial (sin expansor IO ni CPLD)
0: hot-plug administrado, PCIe SHP
PCIe PHP (sin expansor IO ni CPLD)

D D

208 | 308 | 408 | 508 | 808

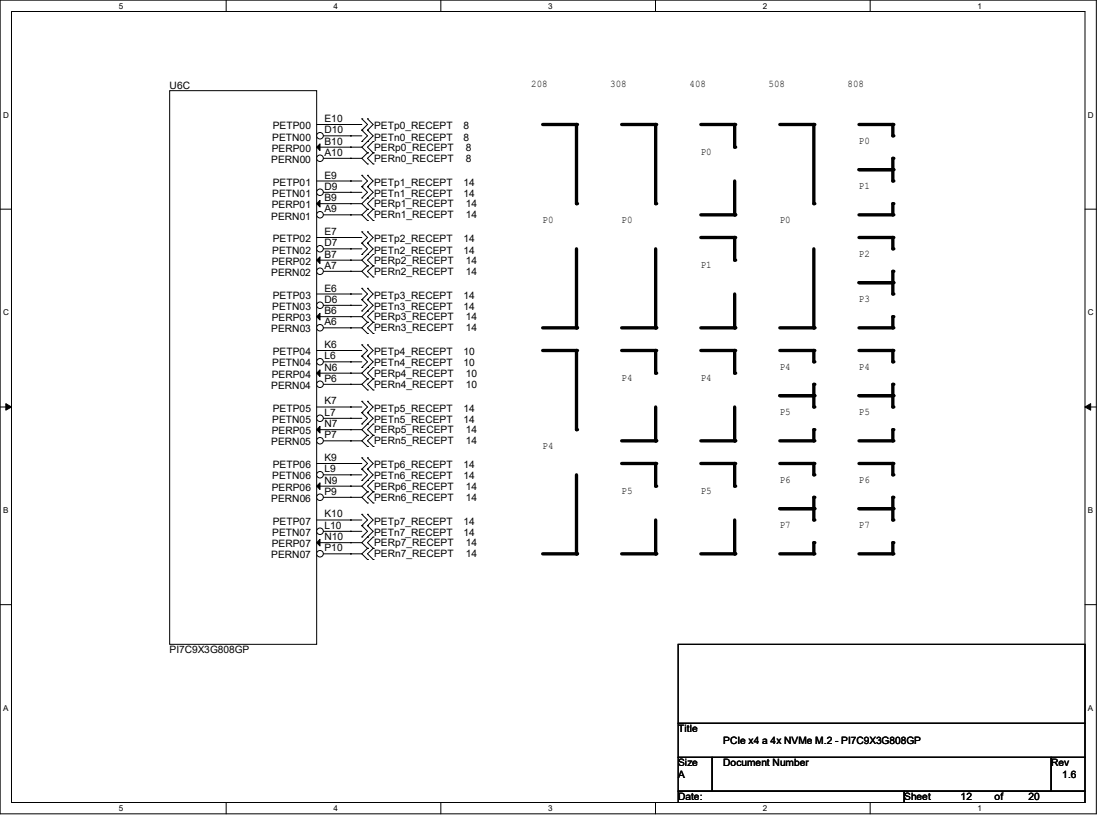
[picture p16: page 11]

55

44

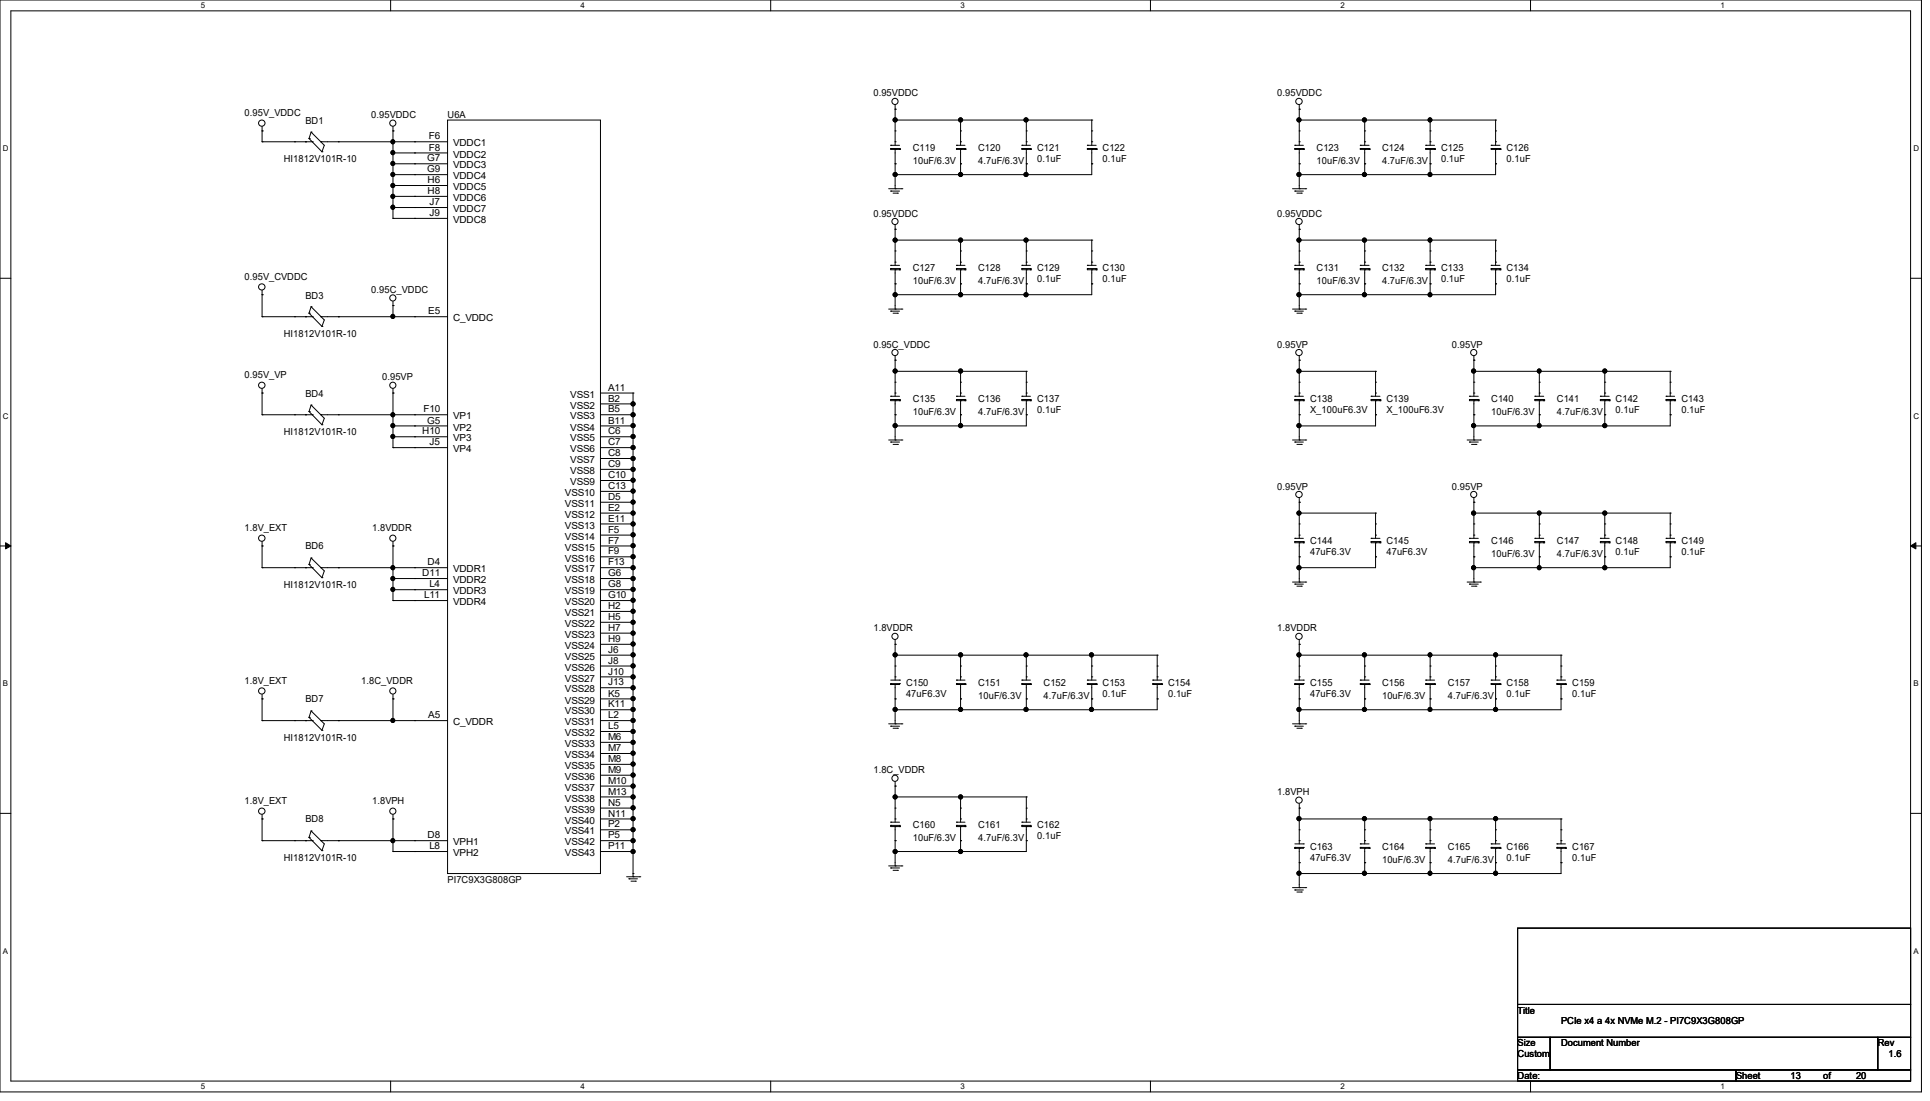
[picture p17: page 12]

D D

# 8 REFCLKIP_R

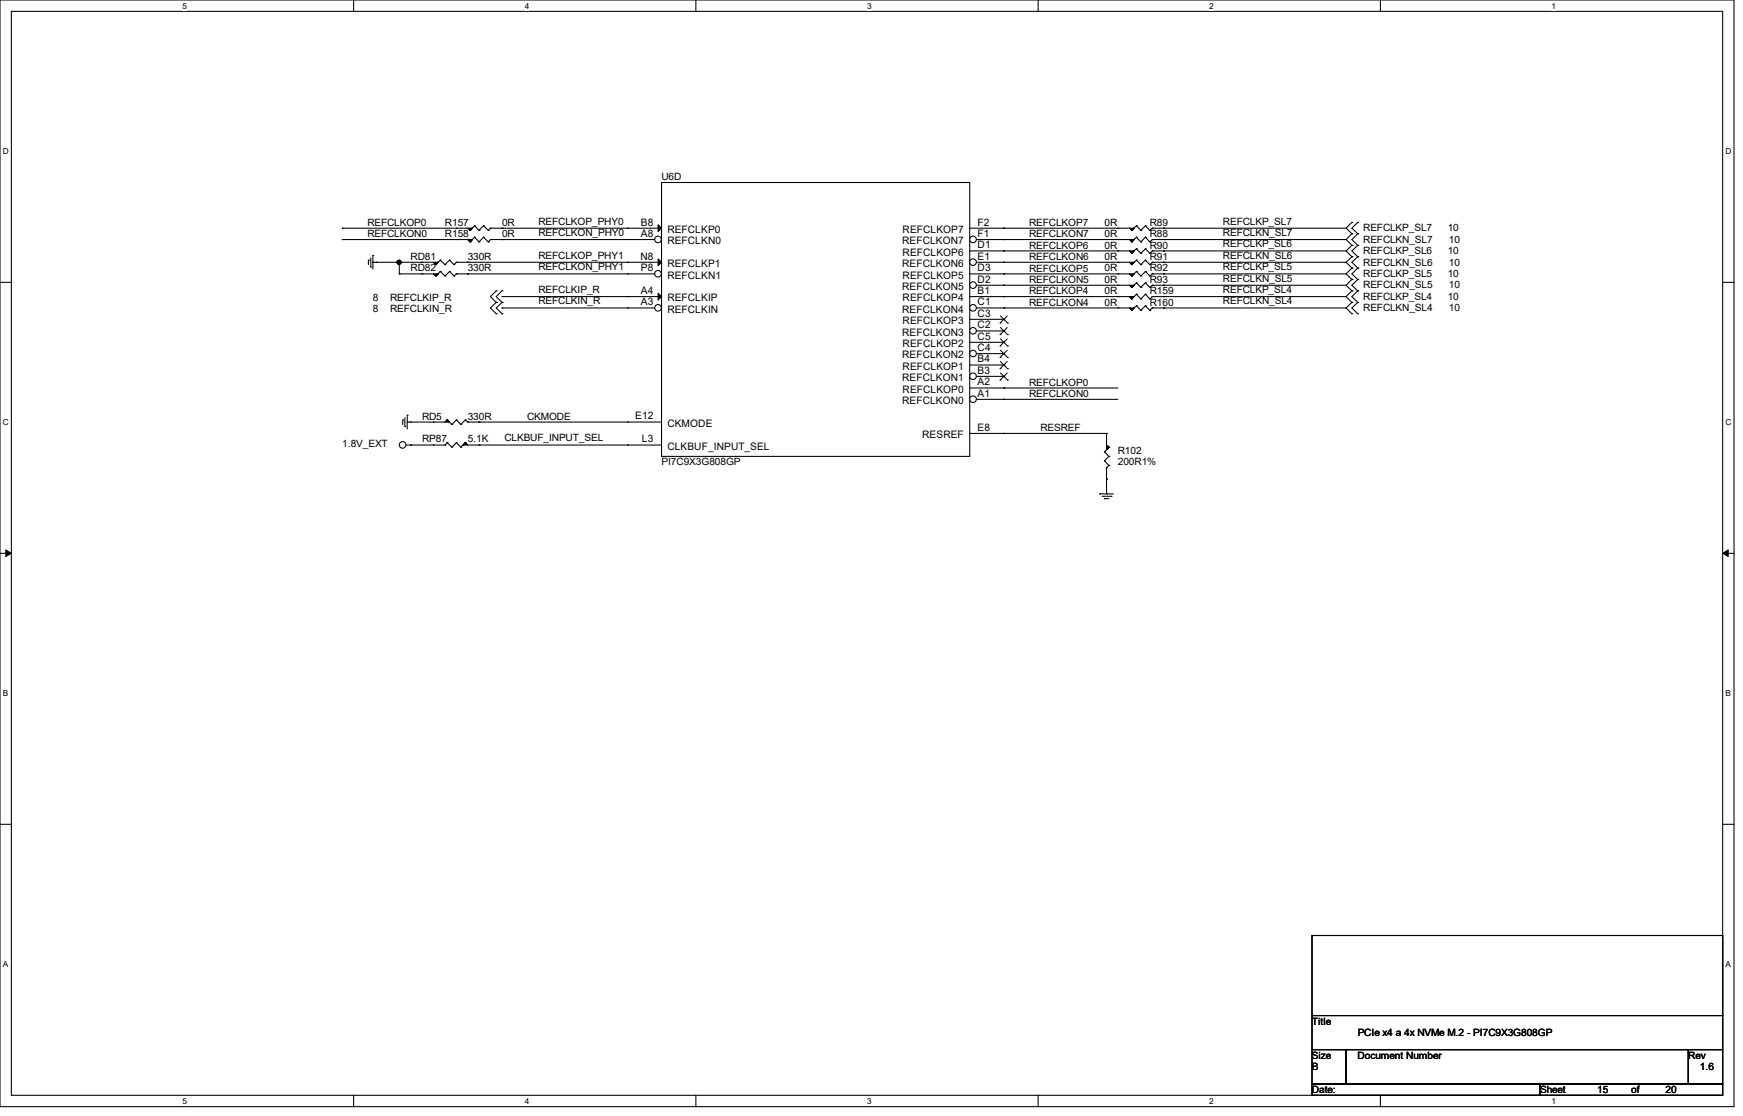
[picture p18: page 13]

D D

# 3.3V_EXT

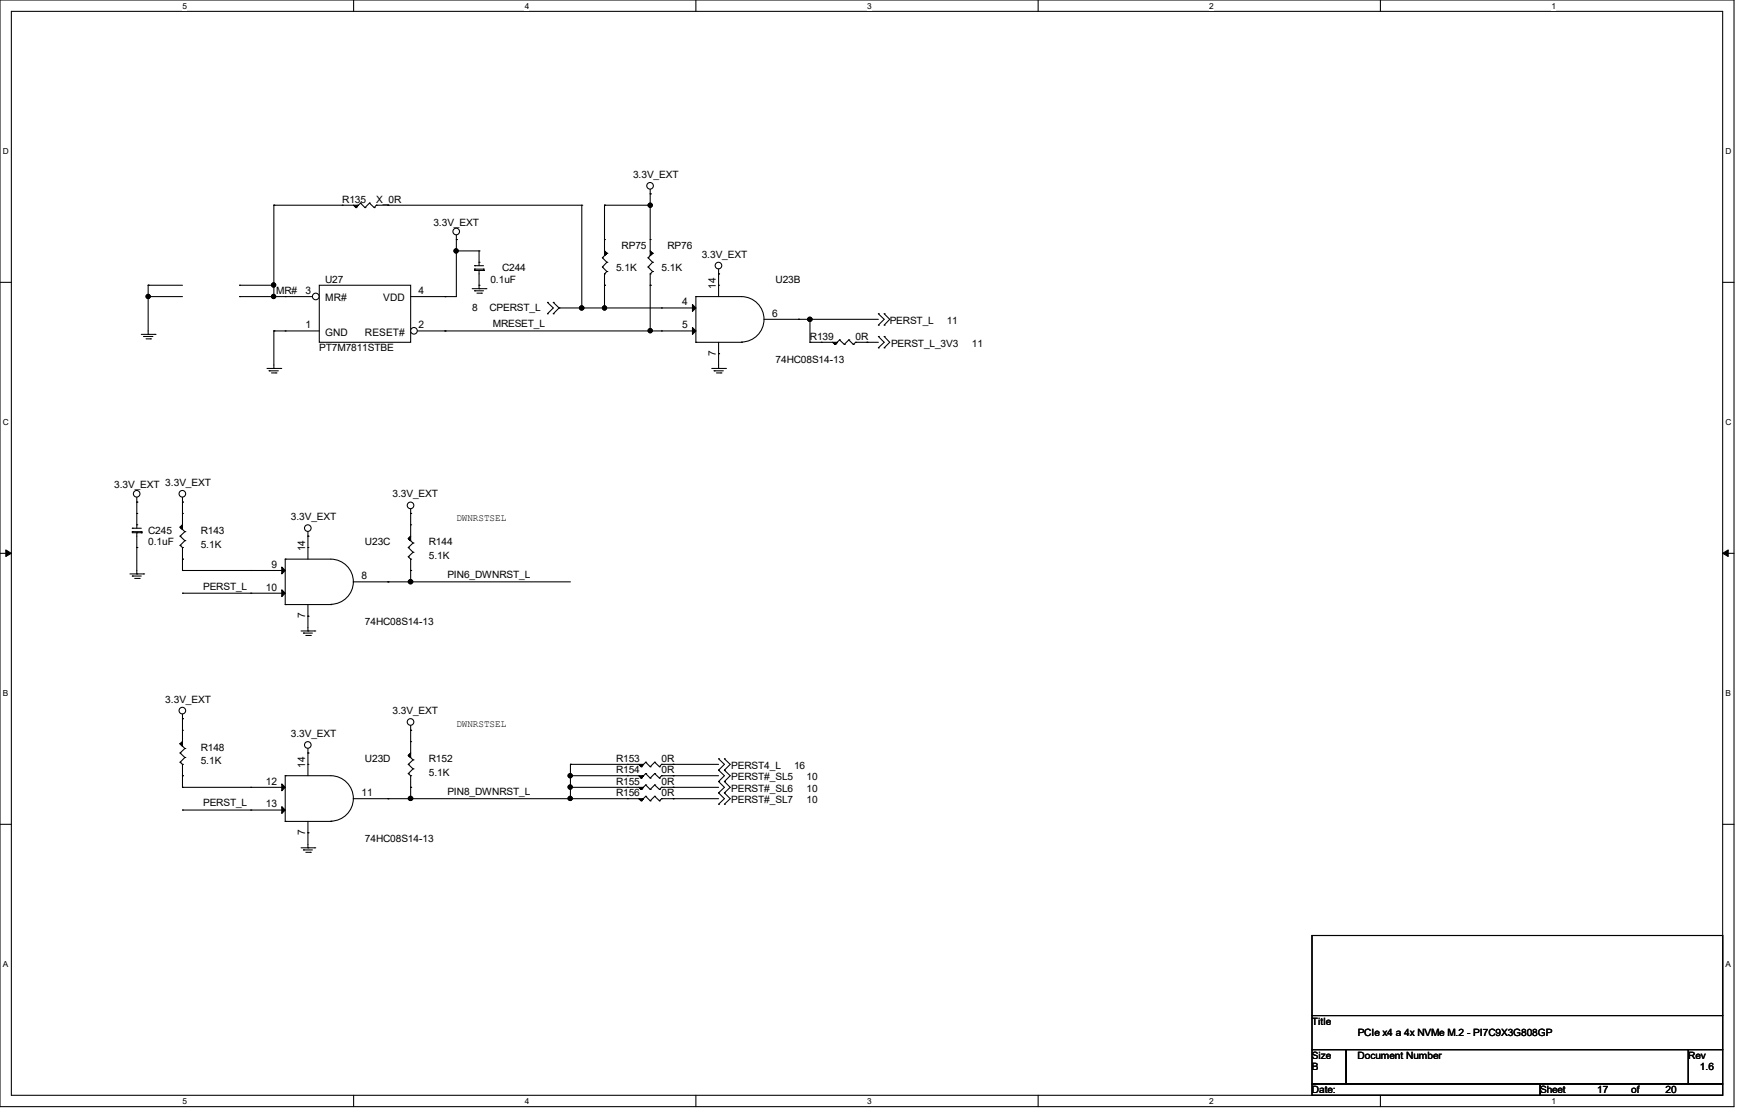
[picture p19: page 14]
