RodrigoQ99/PCIe-Switch-4xNVMe/(list of files, drawings)

Other design files:
esquematico/PCIe_Switch_4xNVMe.DSN
esquematico/PCIe_Switch_4xNVMe.opj
