RodrigoQ99/PCIe-Switch-4xNVMe/(commit log)

2026-10-31 Esquemático con 4 conectores M.2
    [PCIe_Switch_4xNVMe.DSN, PCIe_Switch_4xNVMe.opj]
2026-10-31 Netlist sin errores y placa creada en Allegro
    [PCIe_Switch_4xNVMe.DSN, PCIe_Switch_4xNVMe.brd]
2026-10-31 Esquemático recortado al alcance y placa actualizada
    [PCIe_Switch_4xNVMe.DSN, PCIe_Switch_4xNVMe.brd]
2026-11-02 Layout paso 2: DRC de colocación en 0, regiones de paso fino, 37 pares diferenciales y standoffs 2280
    [PCIe_Switch_4xNVMe.brd]
2026-11-02 Layout: fanout del BGA basado en el EVB, desacoples C0402_BGA y colocación corregida
    [PCIe_Switch_4xNVMe.brd]
2026-11-05 Layout paso 1: limpieza de textos (solo REFDES), vías de periferia fuera, partes altas fuera del módulo M.2, vías térmicas de U1/U2/U3
    [PCIe_Switch_4xNVMe.brd]
2026-11-06 Layout: reglas de pares diferenciales y tolerancia de fase, upstream igualado, planos GND02/PWR05; DRC 0
    [PCIe_Switch_4xNVMe.brd]
2026-11-08 Ruteo r8: DRC 0, fase de los 37 pares <= 1.5 mil, todas las señales conectadas
    [PCIe_Switch_4xNVMe.brd]
2026-11-08 Pasos 5 y 6: planos de potencia, r9 (DRC 0, 0 sin rutear), Gerbers y taladro
    [PCIe_Switch_4xNVMe.brd, art_param.txt, nc_param.txt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]
2026-11-08 Esquemático: portada, diagramas y PDF
    [PCIe_Switch_4xNVMe.DSN]
2026-11-08 Paquete de fabricación en zip
2026-11-08 Vista en PDF de los Gerber y taladros
2026-11-08 Estructura final: esquemático, layout, fabricación e imágenes
    [455580003.psm, 7_3x4_3x2_8.psm, BOM_PCIe_Switch_4xNVMe.csv, PCIe_Switch_4xNVMe.DSN, PCIe_Switch_4xNVMe.opj, art_param.txt, b3qfn-42.psm, c0402.psm]
2026-11-09 Esquematico actualizado
    [PCIe_Switch_4xNVMe.DSN]
